dj1yfk/so5cw-kraftwerk/README.txt

SO5CW DC Power Distributor for Remote operation ("Kraftwerk")

by Fabian Kurz, DJ5CW/SO5CW <fabian@fkurz.net>

Homepage:   https://fkurz.net/ham/kraftwerk/
Repository: https://git.fkurz.net/dj1yfk/so5cw-kraftwerk/
