dj1yfk/so5cw-kraftwerk/kicad/so5cw-power.kicad_pcb

## KiCad design kicad/so5cw-power.kicad_pcb (2026-03-29)

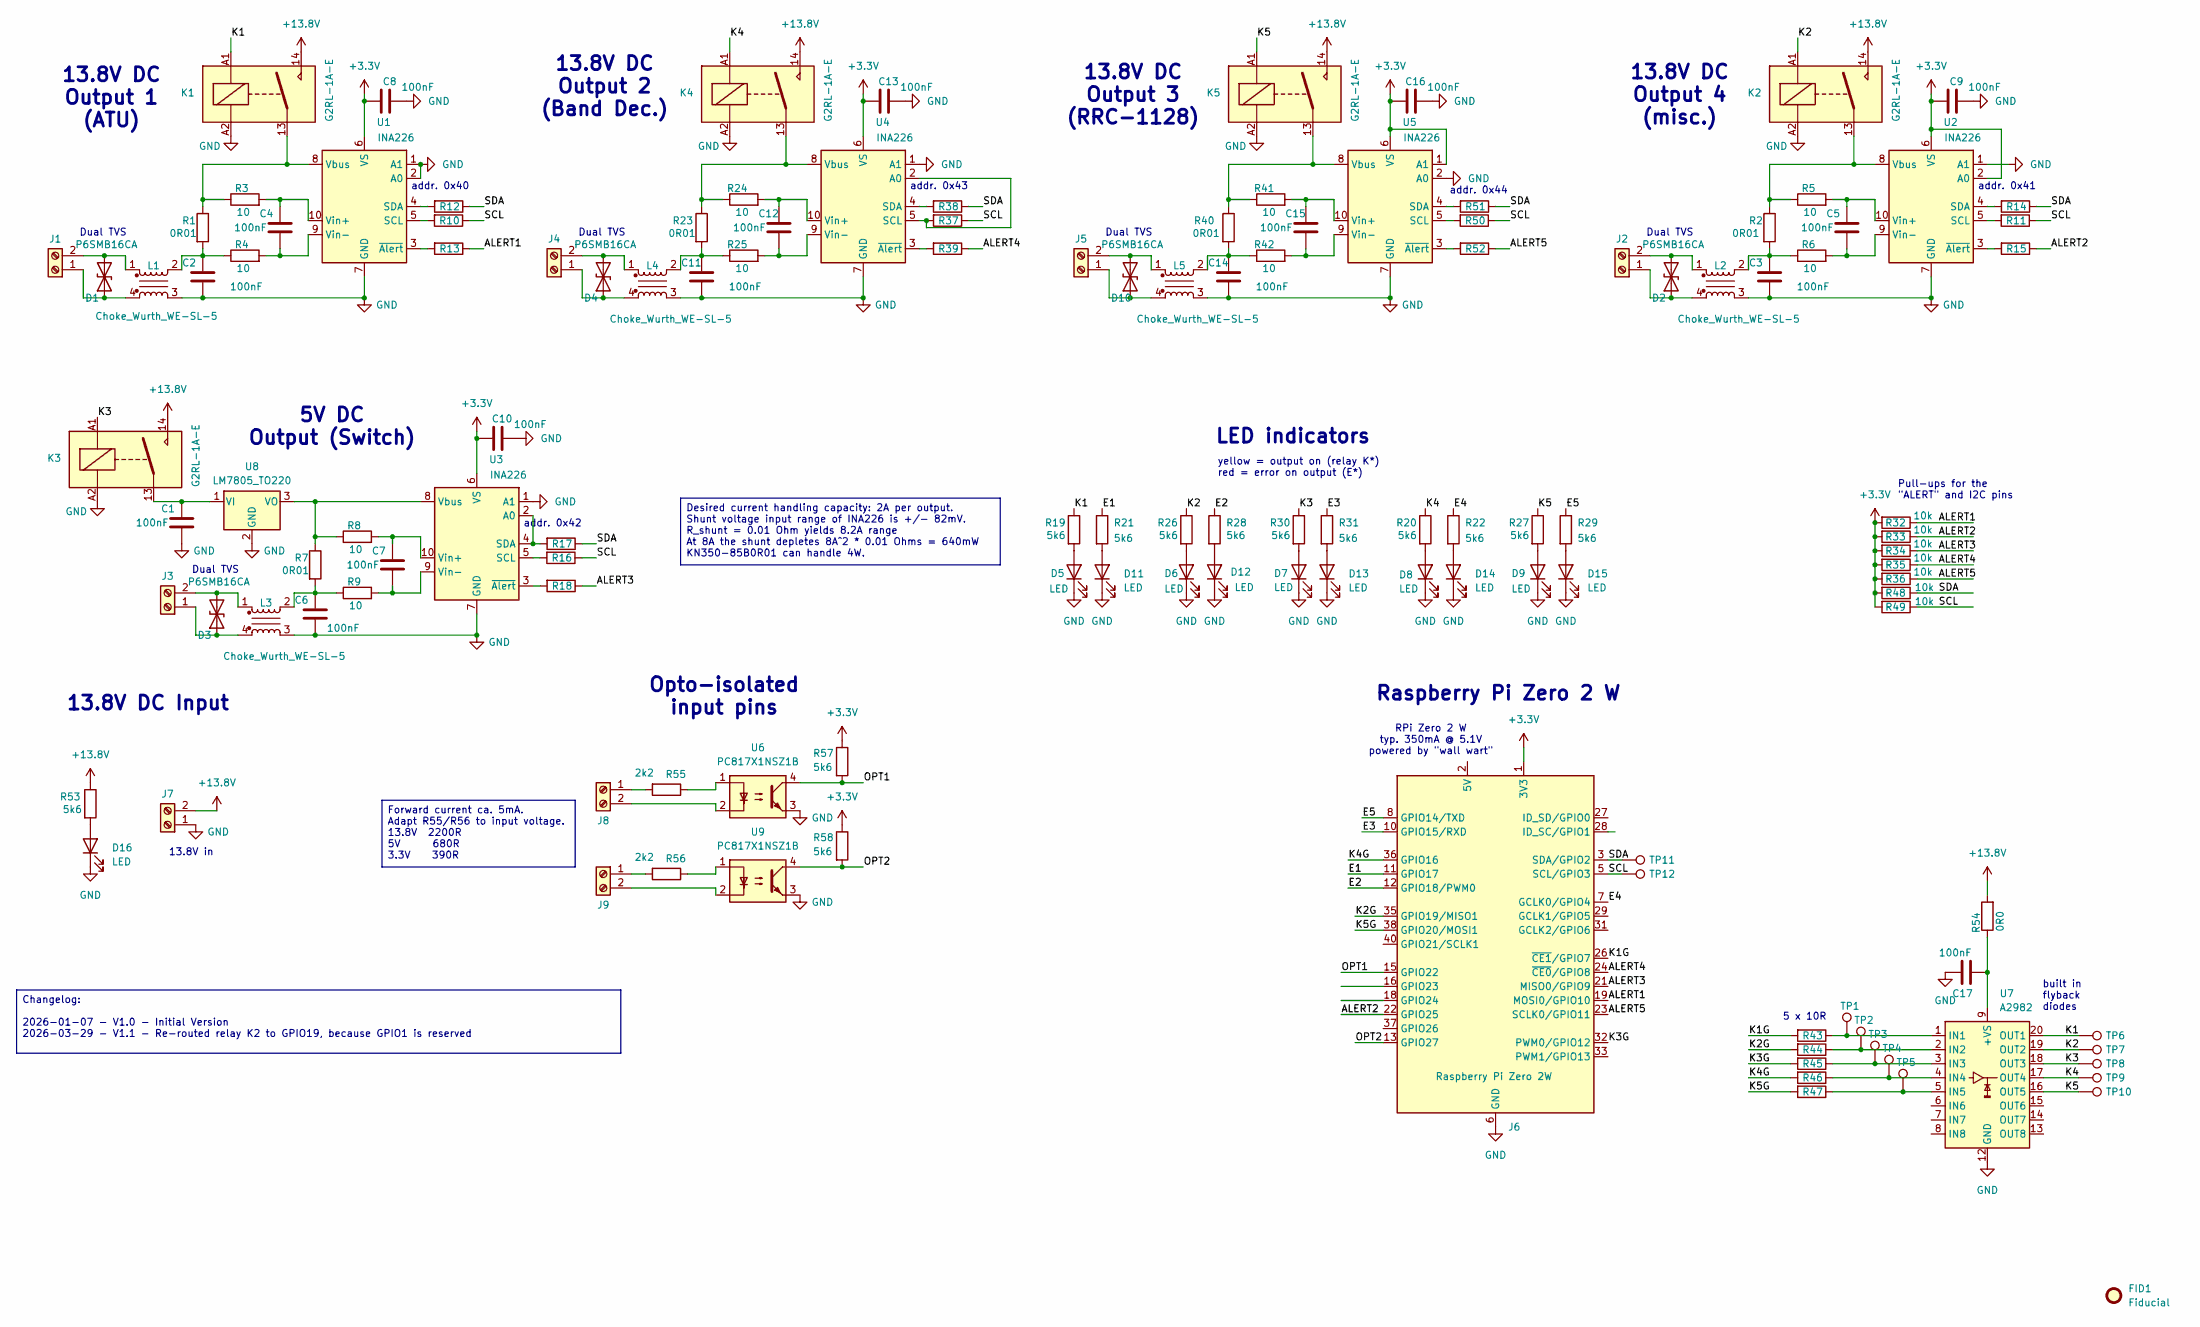
[picture p1: schematic so5cw-power.kicad_sch, SO5CW Remote DC Power Controller ("Kraftwerk")]

Parts:
C1, C2, C3, C4, C5, C6, C7, C8, C9, C10, C11, C12, C13, C14, C15, C16, C17: 100nF; C_0805_2012Metric_Pad1.18x1.45mm_HandSolder
D1, D2, D3, D4, D10: P6SMB16CA; D_SMB_Handsoldering
D5, D6, D7, D8, D9, D11, D12, D13, D14, D15, D16: LED; LED_0603_1608Metric_Pad1.05x0.95mm_HandSolder
FID1: Fiducial; bobik
J1, J2, J3, J4, J5, J7, J8, J9: Screw_Terminal_01x02; TerminalBlock_Phoenix_PT-1,5-2-3.5-H_1x02_P3.50mm_Horizontal
J6: Raspberry Pi Zero 2W; Raspberry Pi Zero W 2
K1, K2, K3, K4, K5: G2RL-1A-E; Relay_SPST_Omron_G2RL-1A-E
L1, L2, L3, L4, L5: Choke_Wurth_WE-SL-5; L_CommonModeChoke_Wuerth_WE-SL5
R1, R2, R7, R23, R40: 0R01; R_Axial_DIN0207_L6.3mm_D2.5mm_P5.08mm_Vertical
R3, R4, R5, R6, R8, R9, R24, R25, R41, R42, R43, R44, R45, R46, R47: 10; R_0603_1608Metric_Pad0.98x0.95mm_HandSolder
R10, R11, R12, R13, R14, R15, R16, R17, R18, R32, R33, R34, R35, R36, R37, R38, R39, R48, R49, R50, R51, R52: 10k; R_0603_1608Metric_Pad0.98x0.95mm_HandSolder
R19, R20, R21, R22, R26, R27, R28, R29, R30, R31, R53, R57, R58: 5k6; R_0603_1608Metric_Pad0.98x0.95mm_HandSolder
R54: 0R0; R_0603_1608Metric_Pad0.98x0.95mm_HandSolder
R55, R56: 2k2; R_0603_1608Metric_Pad0.98x0.95mm_HandSolder
TP1, TP2, TP3, TP4, TP5, TP6, TP7, TP8, TP9, TP10, TP11, TP12: TestPoint; TestPoint_THTPad_1.0x1.0mm_Drill0.5mm
U1, U2, U3, U4, U5: INA226; VSSOP-10_3x3mm_P0.5mm
U6, U9: PC817X1NSZ1B; DIP-4_W7.62mm_LongPads
U7: A2982; SOIC-20W_7.5x12.8mm_P1.27mm
U8: LM7805_TO220; TO-220-3_Vertical

Connections:
+3.3V: C8.1, C9.1, C10.1, C13.1, C16.1, J6.1 (3V3), J6.17 (3V3), R32.2, R33.2, R34.2, R35.2, R36.2, R48.2, R49.2, R57.1, R58.1, U1.6 (VS), U2.2 (A0), U2.6 (VS), U3.6 (VS), U4.6 (VS), U5.1 (A1), U5.6 (VS)
+13.8V: J7.2, K1.14, K2.14, K3.14, K4.14, K5.14, R53.1, R54.2
/ALERT1: J6.19 (MOSI0/GPIO10), R13.1, R32.1
/ALERT2: J6.22 (GPIO25), R15.1, R33.1
/ALERT3: J6.21 (MISO0/GPIO9), R18.1, R34.1
/ALERT4: J6.24 (~CE0/GPIO8), R35.1, R39.1
/ALERT5: J6.23 (SCLK0/GPIO11), R36.1, R52.1
/E1: J6.11 (GPIO17), R21.1
/E2: J6.12 (GPIO18/PWM0), R28.1
/E3: J6.10 (GPIO15/RXD), R31.1
/E4: J6.7 (GCLK0/GPIO4), R22.1
/E5: J6.8 (GPIO14/TXD), R29.1
/K1: K1.A1, R19.1, TP6.1, U7.20 (OUT1)
/K1G: J6.26 (~CE1/GPIO7), R43.2
/K2: K2.A1, R26.1, TP7.1, U7.19 (OUT2)
/K2G: J6.35 (GPIO19/MISO1), R44.2
/K3: K3.A1, R30.1, TP8.1, U7.18 (OUT3)
/K3G: J6.32 (PWM0/GPIO12), R45.2
/K4: K4.A1, R20.1, TP9.1, U7.17 (OUT4)
/K4G: J6.36 (GPIO16), R46.2
/K5: K5.A1, R27.1, TP10.1, U7.16 (OUT5)
/K5G: J6.38 (GPIO20/MOSI1), R47.2
/OPT1: J6.15 (GPIO22), R57.2, U6.4
/OPT2: J6.13 (GPIO27), R58.2, U9.4
/SCL: J6.5 (SCL/GPIO3), R10.1, R11.1, R16.1, R37.1, R49.1, R50.1, TP12.1
/SDA: J6.3 (SDA/GPIO2), R12.1, R14.1, R17.1, R38.1, R48.1, R51.1, TP11.1
GND: C1.2, C2.2, C3.2, C6.2, C8.2, C9.2, C10.2, C11.2, C13.2, C14.2, C16.2, C17.1, D5.1 (K), D6.1 (K), D7.1 (K), D8.1 (K), D9.1 (K), D11.1 (K), D12.1 (K), D13.1 (K), D14.1 (K), D15.1 (K), D16.1 (K), J6.6 (GND), J6.9 (GND), J6.14 (GND), J6.20 (GND), J6.25 (GND), J6.30 (GND), J6.34 (GND), J6.39 (GND), J7.1, K1.A2, K2.A2, K3.A2, K4.A2, K5.A2, L1.3, L2.3, L3.3, L4.3, L5.3, U1.1 (A1), U1.2 (A0), U1.7 (GND), U2.1 (A1), U2.7 (GND), U3.1 (A1), U3.7 (GND), U4.1 (A1), U4.7 (GND), U5.2 (A0), U5.7 (GND), U6.3, U7.12 (GND), U8.2 (GND), U9.3
unnamed: C2.1, L1.2, R1.2, R4.1
unnamed: C3.1, L2.2, R2.2, R6.1
unnamed: C6.1, L3.2, R7.2, R9.1
unnamed: C11.1, L4.2, R23.2, R25.1
unnamed: C14.1, L5.2, R40.2, R42.1
unnamed: D1.1 (A1), J1.1, L1.4
unnamed: D1.2 (A2), J1.2, L1.1
unnamed: D2.1 (A1), J2.1, L2.4
unnamed: D2.2 (A2), J2.2, L2.1
unnamed: D3.1 (A1), J3.1, L3.4
unnamed: D3.2 (A2), J3.2, L3.1
unnamed: D4.1 (A1), J4.1, L4.4
unnamed: D4.2 (A2), J4.2, L4.1
unnamed: D5.2 (A), R19.2
unnamed: D6.2 (A), R26.2
unnamed: D7.2 (A), R30.2
unnamed: D8.2 (A), R20.2
unnamed: D9.2 (A), R27.2
unnamed: D10.1 (A1), J5.1, L5.4
unnamed: D10.2 (A2), J5.2, L5.1
unnamed: D11.2 (A), R21.2
unnamed: D12.2 (A), R28.2
unnamed: D13.2 (A), R31.2
unnamed: D14.2 (A), R22.2
unnamed: D15.2 (A), R29.2
unnamed: D16.2 (A), R53.2
unnamed: J6.2 (5V), J6.4 (5V)
unnamed: J8.1, R55.2
unnamed: J8.2, U6.2
unnamed: J9.1, R56.2
unnamed: J9.2, U9.2
unnamed: R55.1, U6.1
unnamed: R56.1, U9.1
unnamed: R10.2, U1.5 (SCL)
unnamed: R12.2, U1.4 (SDA)
unnamed: K1.13, R1.1, R3.1, U1.8 (Vbus)
unnamed: C4.1, R3.2, U1.10 (Vin+)
unnamed: C4.2, R4.2, U1.9 (Vin-)
unnamed: R13.2, U1.3 (~Alert)
unnamed: R11.2, U2.5 (SCL)
unnamed: R14.2, U2.4 (SDA)
unnamed: K2.13, R2.1, R5.1, U2.8 (Vbus)
unnamed: C5.1, R5.2, U2.10 (Vin+)
unnamed: C5.2, R6.2, U2.9 (Vin-)
unnamed: R15.2, U2.3 (~Alert)
unnamed: R17.2, U3.2 (A0), U3.4 (SDA)
unnamed: R16.2, U3.5 (SCL)
unnamed: R7.1, R8.1, U3.8 (Vbus), U8.3 (VO)
unnamed: C7.1, R8.2, U3.10 (Vin+)
unnamed: C7.2, R9.2, U3.9 (Vin-)
unnamed: R18.2, U3.3 (~Alert)
unnamed: R37.2, U4.2 (A0), U4.5 (SCL)
unnamed: R38.2, U4.4 (SDA)
unnamed: K4.13, R23.1, R24.1, U4.8 (Vbus)
unnamed: C12.1, R24.2, U4.10 (Vin+)
unnamed: C12.2, R25.2, U4.9 (Vin-)
unnamed: R39.2, U4.3 (~Alert)
unnamed: R50.2, U5.5 (SCL)
unnamed: R51.2, U5.4 (SDA)
unnamed: K5.13, R40.1, R41.1, U5.8 (Vbus)
unnamed: C15.1, R41.2, U5.10 (Vin+)
unnamed: C15.2, R42.2, U5.9 (Vin-)
unnamed: R52.2, U5.3 (~Alert)
unnamed: C17.2, R54.1, U7.9 (+VS)
unnamed: R43.1, TP1.1, U7.1 (IN1)
unnamed: R44.1, TP2.1, U7.2 (IN2)
unnamed: R45.1, TP3.1, U7.3 (IN3)
unnamed: R46.1, TP4.1, U7.4 (IN4)
unnamed: R47.1, TP5.1, U7.5 (IN5)
unnamed: C1.1, K3.13, U8.1 (VI)

Notes on the sheet:
13.8V DC Output 2 (Band Dec.)
addr. 0x41
Pull-ups for the "ALERT" and I2C pins
Dual TVS
built in flyback diodes
5V DC Output (Switch)
addr. 0x40
13.8V in
13.8V DC Input
addr. 0x44
addr. 0x43
Opto-isolated input pins
13.8V DC Output 4 (misc.)
addr. 0x42
RPi Zero 2 W typ. 350mA @ 5.1V powered by "wall wart"
Raspberry Pi Zero 2 W
5 x 10R
LED indicators
13.8V DC Output 1 (ATU)
13.8V DC Output 3 (RRC-1128)
yellow = output on (relay K*) red = error on output (E*)
Desired current handling capacity: 2A per output. Shunt voltage input range of INA226 is +/- 82mV. R_shunt = 0.01 Ohm yields 8.2A range At 8A the shunt depletes 8A^2 * 0.01 Ohms = 640mW KN350-85B0R01 can handle 4W.
Changelog: 2026-01-07 - V1.0 - Initial Version 2026-03-29 - V1.1 - Re-routed relay K2 to GPIO19, because GPIO1 is reserved
Forward current ca. 5mA. Adapt R55/R56 to input voltage. 13.8V 2200R 5V 680R 3.3V 390R

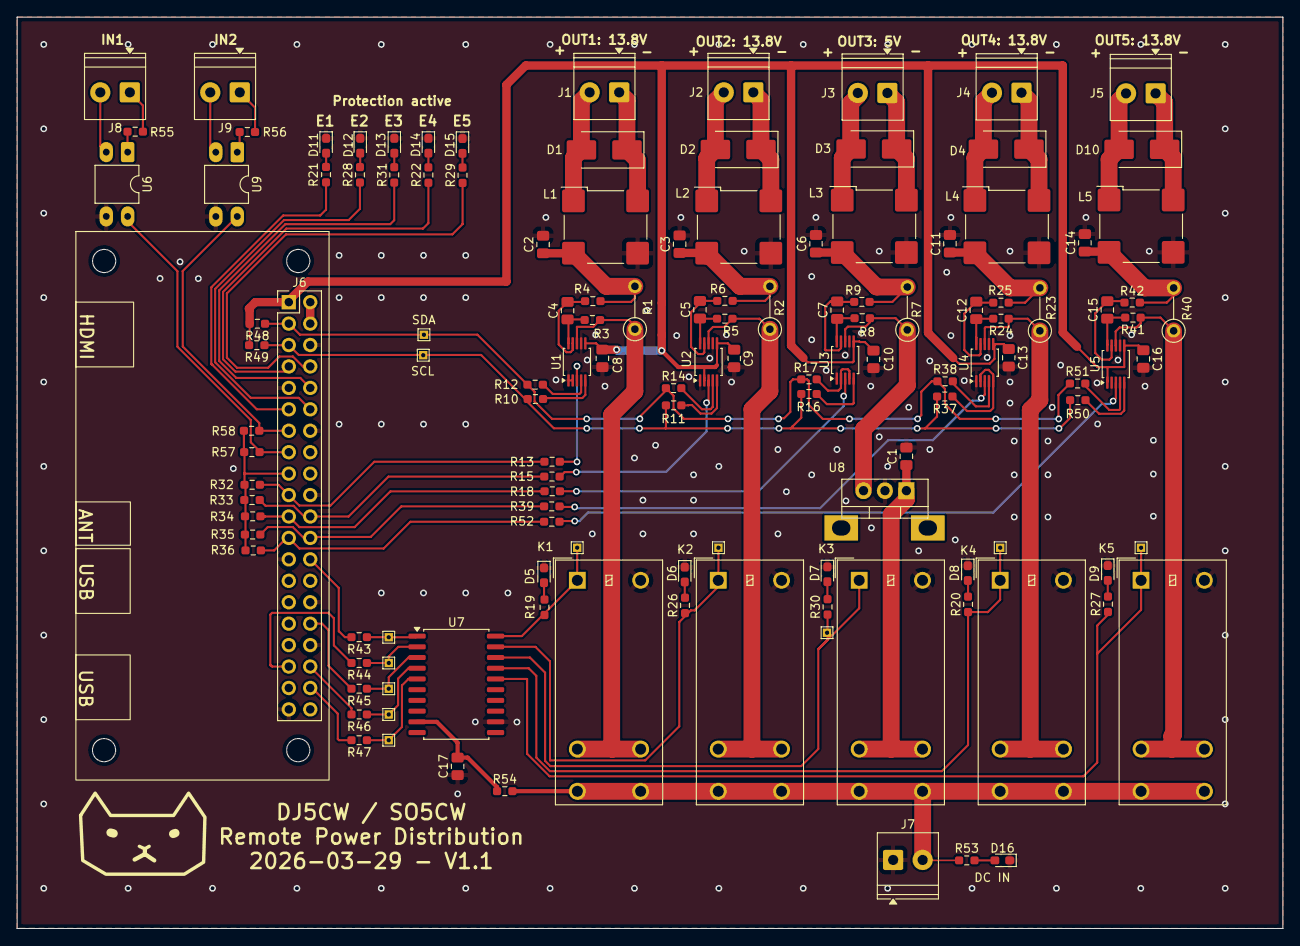
[picture p2: board so5cw-power.kicad_pcb from above]

Board: 2 copper layers, 150.0 x 108.0 mm, 132 parts (0 on the bottom side), 97 nets.
