dj1yfk/so5cw-kraftwerk/(commit log)

2026-03-15 Initial commit. WIP - Software for SO5CW remote power switch
2026-03-15 add "fuse" functions, syslog output
2026-03-22 add PCB v1.0
    [so5cw-power.kicad_pcb, so5cw-power.kicad_sch]
2026-03-22 add measured voltage to alert message
2026-03-22 FW: read current a 2nd time before blowing the fuse
    In long term tests, there were occasional I2C read errors that lead
    to switching off a channel that did not have an overload condition.
    Therefore, if we detect an overcurrent, read the current twice, and
    only if that second reading is also above the limit, switch off.
    The 2nd read occurs within a millisecond of the first one, so there
    is little danger that anything goes up in smoke in the meantime.
    [so5cw-kraftwerk.py]
2026-03-24 Connect Relay K2 to GPIO19, because GPIO1 is reserved
    [so5cw-power.kicad_pcb, so5cw-power.kicad_sch]
2026-03-29 Version 1.1 (K2 re-routed from GPIO1 to GPIO19). Cosmetics.
    [so5cw-power.kicad_pcb, so5cw-power.kicad_sch]
2026-03-29 Add history of opto coupler input pins. Rename channels to physical name (1-5).
2026-03-29 schematic: rearrange outputs (1..5) and adjust descriptions
    [so5cw-power.kicad_sch]
